Marketto/AvocadoBook/docs/pdf/modello_foglio_schermo_A4.pdf

linguetta: resta fuori dalla fessura per sfilare il foglio

### disegna qui (area visibile dello schermo, 230 x 144 mm)

Taglia lungo la linea continua (235 x 162 mm). Stampa al 100%, senza "adatta alla pagina". Inserisci dal bordo superiore del coperchio.

controllo scala: 50 mm
