Marketto/AvocadoBook/docs/img/avocado.png

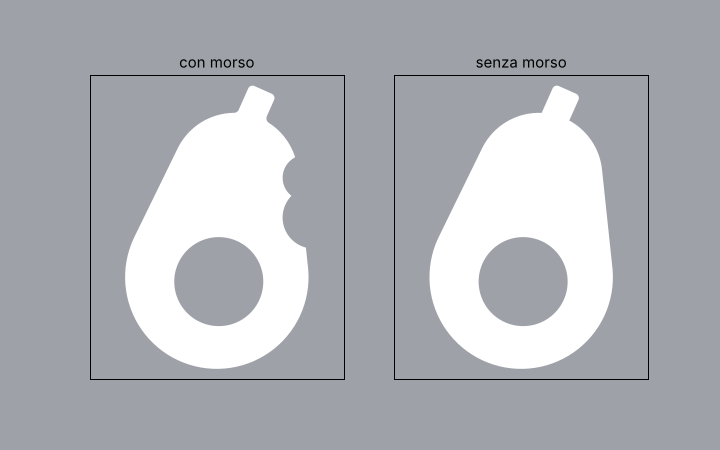
docs/img/avocado.png
