Marketto/AvocadoBook/docs/img/fondo_molle_inserite.png

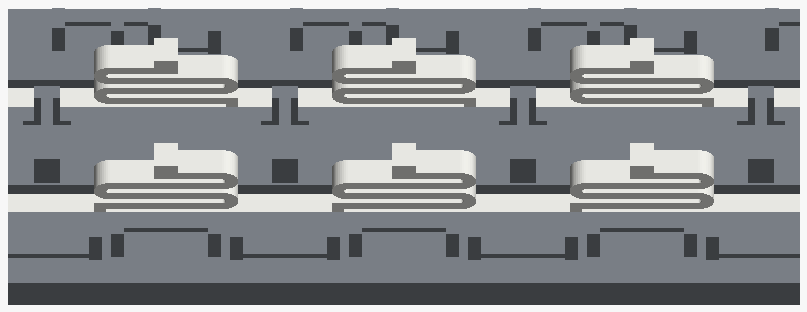
docs/img/fondo_molle_inserite.png
