Marketto/AvocadoBook/docs/img/fondo_scritta.png

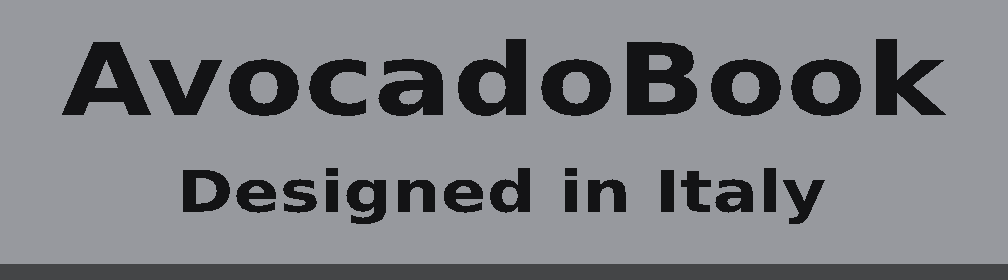
docs/img/fondo_scritta.png
