Marketto/AvocadoBook/docs/img/sezione_cerniera.png

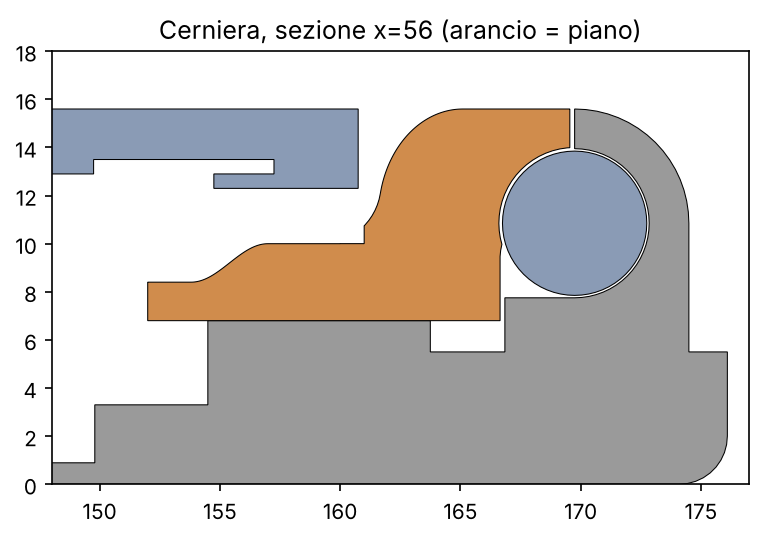
docs/img/sezione_cerniera.png
