Marketto/AvocadoBook/print/AvocadoBook_progetto.3mf

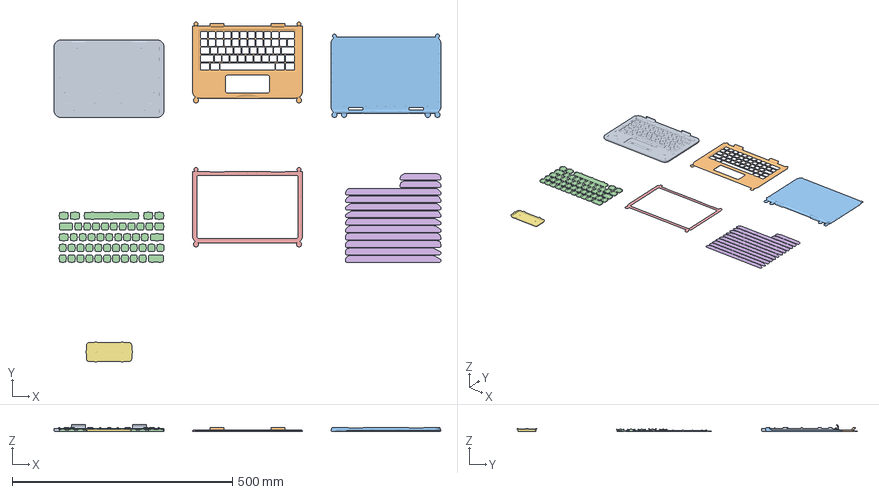
[picture p6: CAD file, 2026-11-07]
print/AvocadoBook_progetto.3mf
878.8 x 772.4 x 15.6 mm
1_fondo - 1 GRIGIO PETG + 3 NERO PETG
2_piano - 1 GRIGIO PETG
3_coperchio - 1 GRIGIO PETG + 2 BIANCO PETG + 3 NERO PETG + 4 PLA (supporti)
4_tasti - 2 BIANCO PETG + 3 NERO PETG
5_cornice_schermo - 3 NERO PETG
6_molle_S - 2 BIANCO PETG + 4 PLA (supporti)
7_trackpad - 1 GRIGIO PETG
