Marketto/AvocadoBook/print/plates/6_molle_S_oggetto_unico.3mf

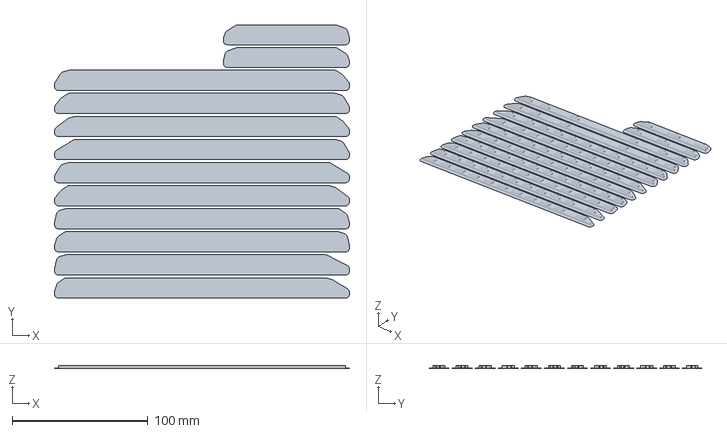
[picture p7: CAD file, 2026-11-07]
print/plates/6_molle_S_oggetto_unico.3mf
217.4 x 201.4 x 2.40 mm
