Marketto/AvocadoBook/print/stl/F_molle_S_fila1_dietro.stl

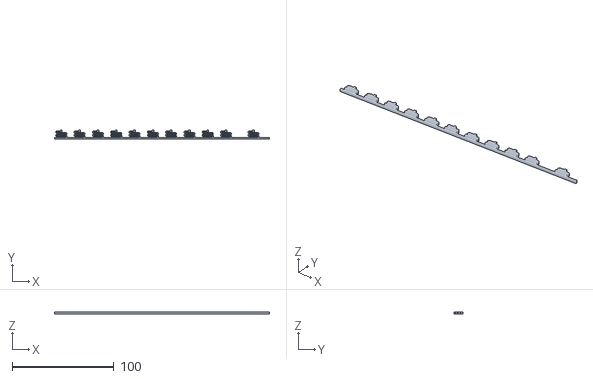
[picture p8: CAD file, 2026-11-07]
print/stl/F_molle_S_fila1_dietro.stl
211.4 x 9.00 x 2.00
