Marketto/AvocadoBook/print/tests/TEST_20_porta_usbc.3mf

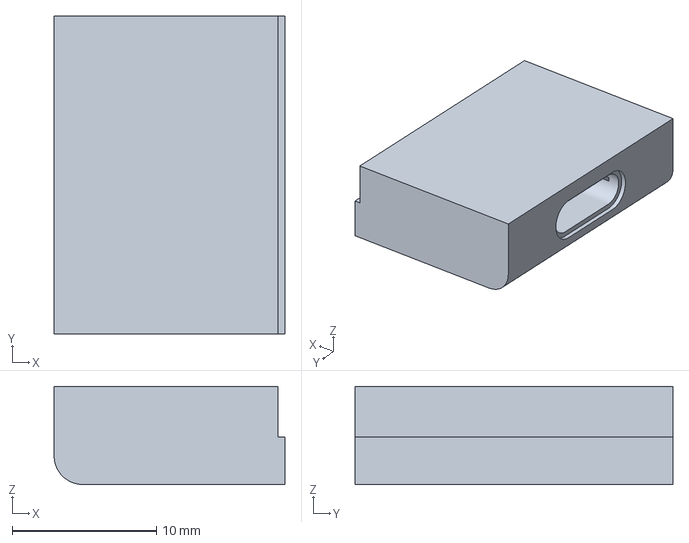
[picture p9: CAD file, 2026-11-07]
print/tests/TEST_20_porta_usbc.3mf
16.0 x 22.0 x 6.80 mm
