Marketto/AvocadoBook/print/plates/5_cornice_schermo.3mf

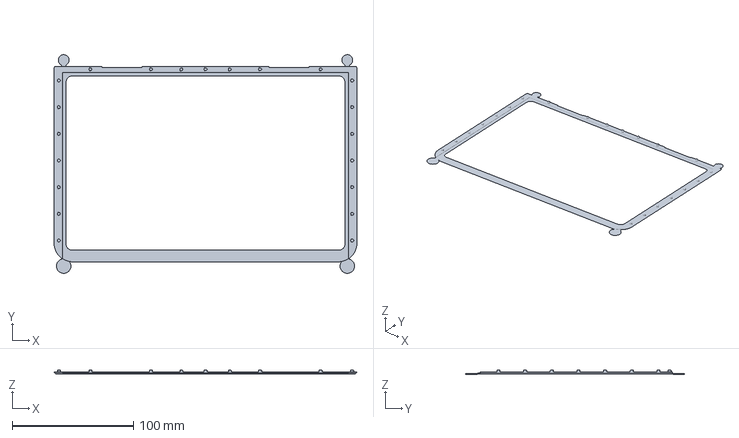
[picture p10: CAD file, 2026-11-07]
print/plates/5_cornice_schermo.3mf
250.0 x 180.5 x 3.70 mm
