Marketto/AvocadoBook/print/stl/D_tasti.stl

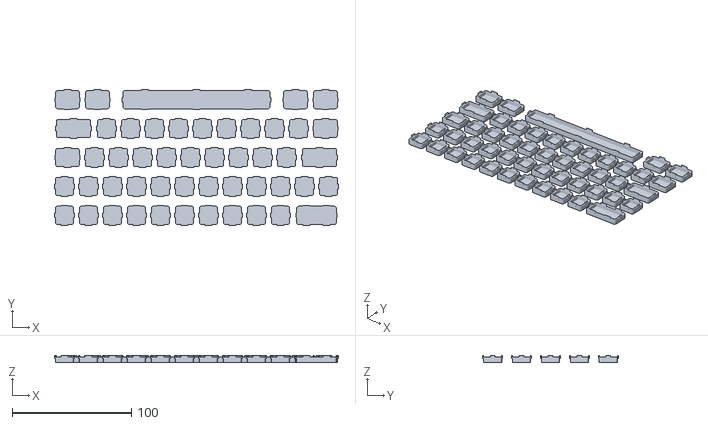
[picture p11: CAD file, 2026-11-07]
print/stl/D_tasti.stl
238.6 x 114.0 x 6.00
