Marketto/AvocadoBook/print/tests/TEST_27_cerniera_senza_fessure.3mf

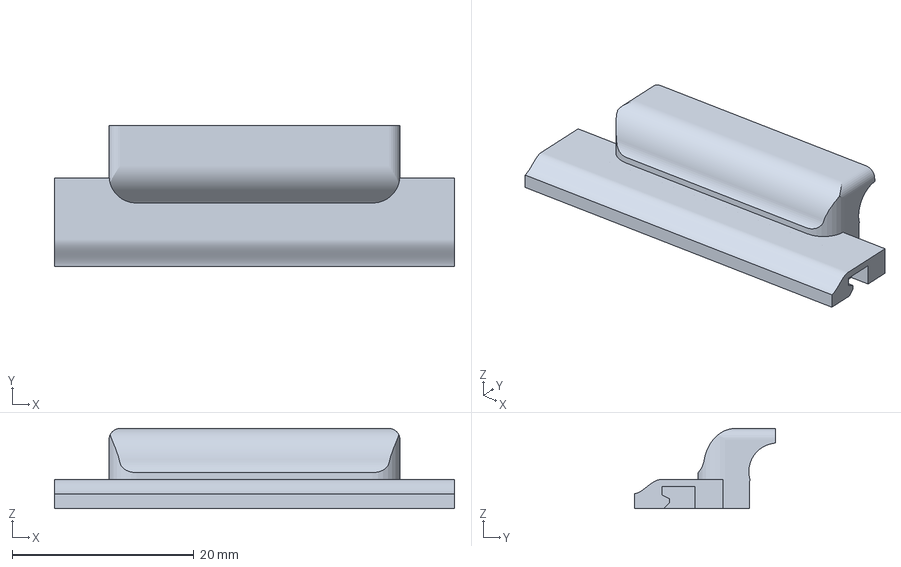
[picture p12: CAD file, 2026-11-07]
print/tests/TEST_27_cerniera_senza_fessure.3mf
44.0 x 15.6 x 8.80 mm
