Marketto/AvocadoBook/print/plates/1_fondo.3mf

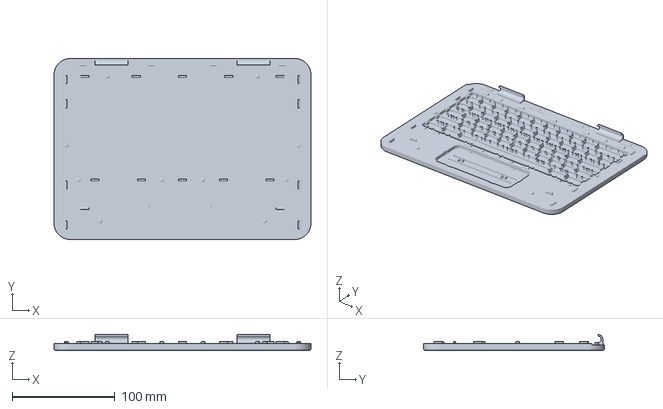
[picture p13: CAD file, 2026-11-07]
print/plates/1_fondo.3mf
250.0 x 176.1 x 15.6 mm
1 GRIGIO PETG
3 NERO PETG
