Marketto/AvocadoBook/print/stl/C_supporto_PLA.stl

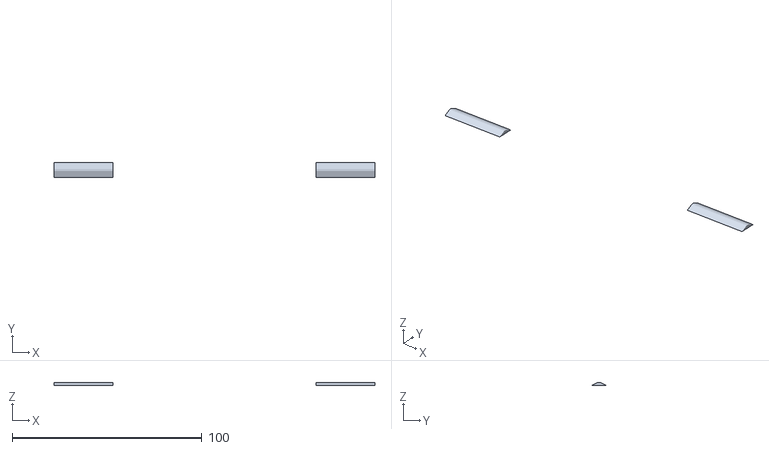
[picture p14: CAD file, 2026-11-07]
print/stl/C_supporto_PLA.stl
169.2 x 8.00 x 1.65
