Marketto/AvocadoBook/print/tests/TEST_28_fondo_avocadobook.3mf

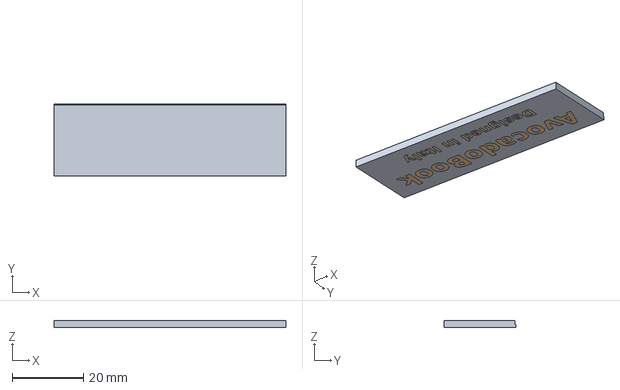
[picture p15: CAD file, 2026-11-07]
print/tests/TEST_28_fondo_avocadobook.3mf
65.1 x 20.1 x 2.00 mm
1 GRIGIO PETG
3 NERO PETG
