Marketto/AvocadoBook/print/plates/2_piano.3mf

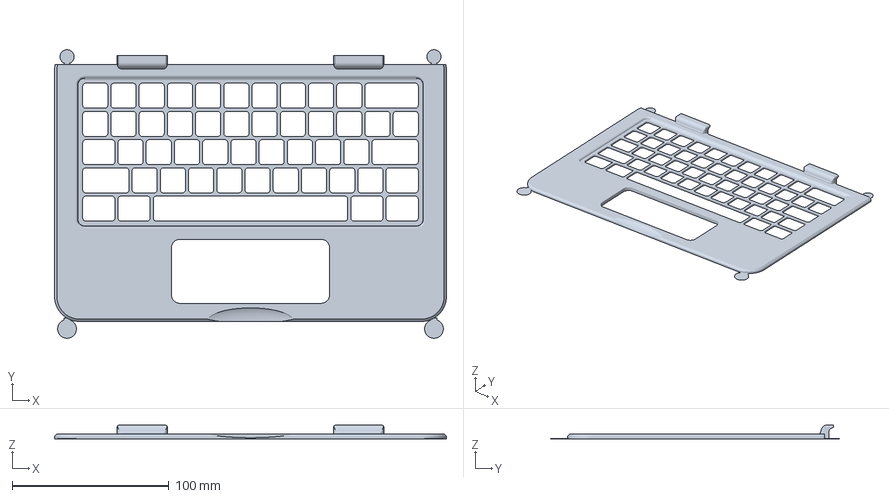
[picture p16: CAD file, 2026-11-07]
print/plates/2_piano.3mf
250.0 x 184.1 x 8.80 mm
