Marketto/AvocadoBook/print/stl/F_molle_S_trackpad_dietro.stl

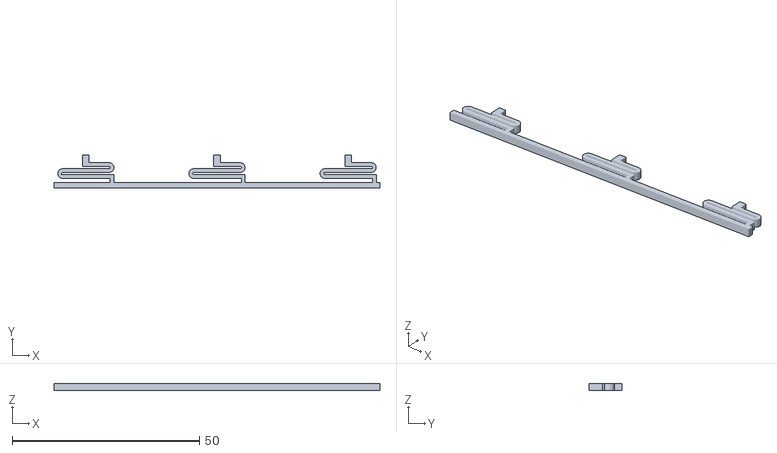
[picture p17: CAD file, 2026-11-07]
print/stl/F_molle_S_trackpad_dietro.stl
87.0 x 8.70 x 2.00
