Marketto/AvocadoBook/print/plates/3_coperchio_oggetto_unico.3mf

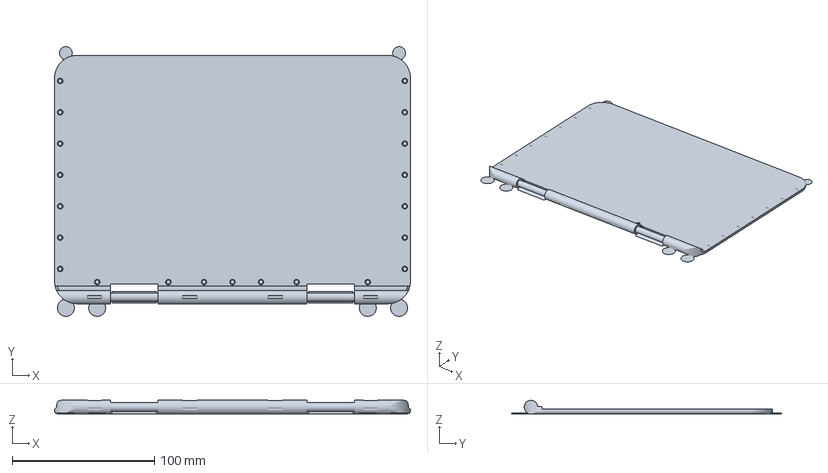
[picture p18: CAD file, 2026-11-07]
print/plates/3_coperchio_oggetto_unico.3mf
250.0 x 189.4 x 9.50 mm
