Marketto/AvocadoBook/print/plates/7_trackpad.3mf

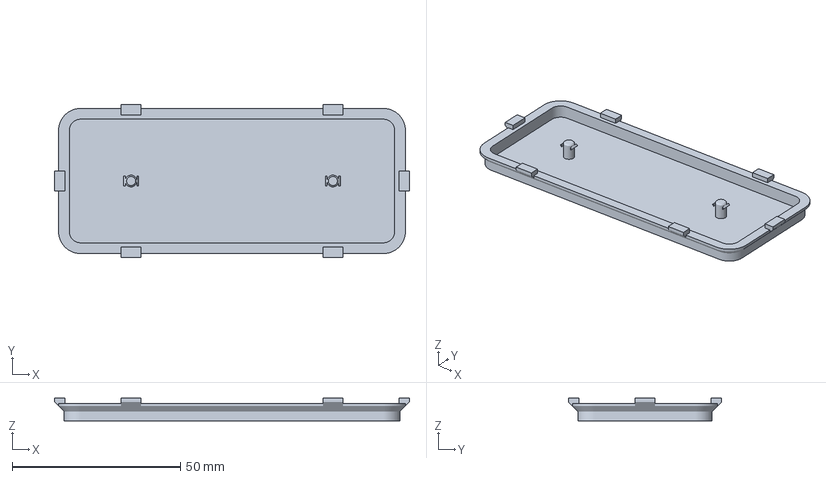
[picture p19: CAD file, 2026-11-07]
print/plates/7_trackpad.3mf
105.6 x 45.6 x 6.70 mm
