Marketto/AvocadoBook/print/stl/C_coperchio_schermo.stl

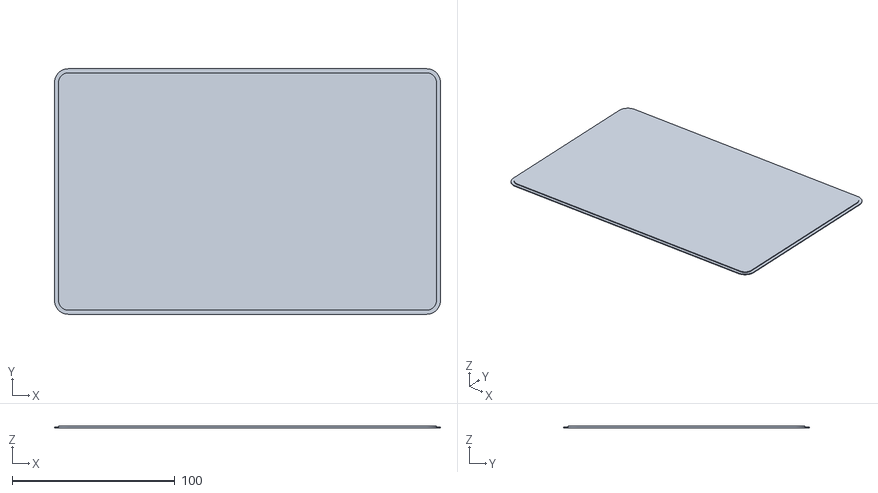
[picture p20: CAD file, 2026-11-07]
print/stl/C_coperchio_schermo.stl
237.0 x 150.7 x 1.20
