Marketto/AvocadoBook/print/plates/4_tasti.3mf

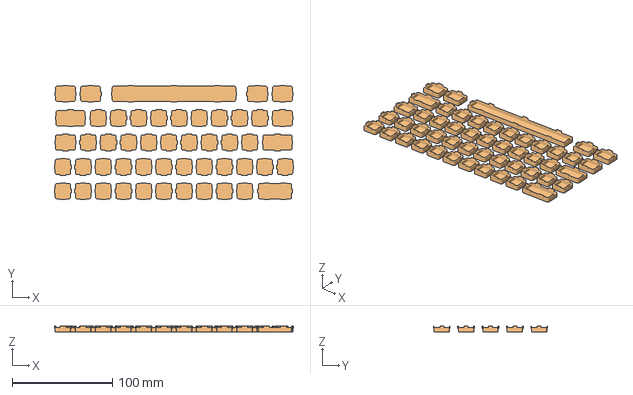
[picture p21: CAD file, 2026-11-07]
print/plates/4_tasti.3mf
238.6 x 114.0 x 6.00 mm
2 BIANCO PETG
3 NERO PETG
