Marketto/AvocadoBook/print/stl/D_lettere.stl

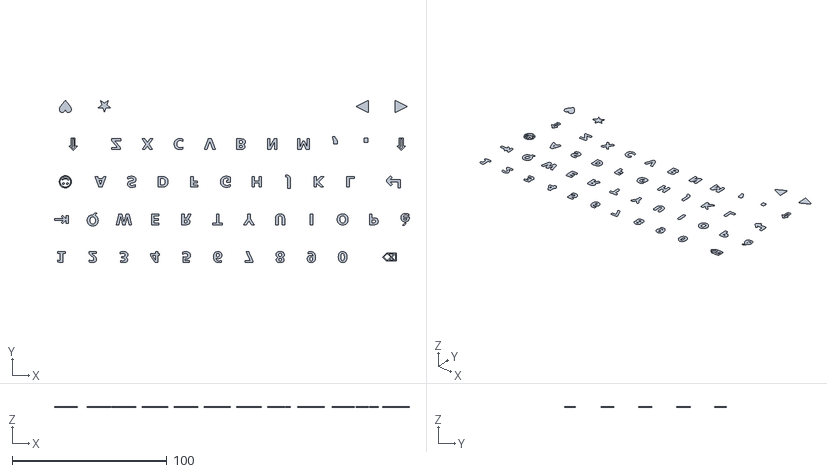
[picture p22: CAD file, 2026-11-07]
print/stl/D_lettere.stl
229.1 x 104.8 x 0.6
