Marketto/AvocadoBook/print/stl/A_fondo_scritta_nera.stl

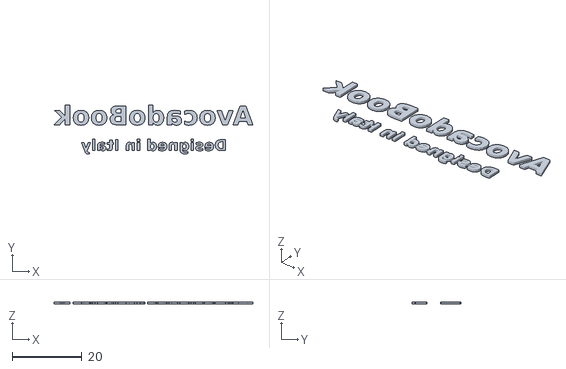
[picture p23: CAD file, 2026-11-07]
print/stl/A_fondo_scritta_nera.stl
57.1 x 14.1 x 0.6
