Marketto/AvocadoBook/print/stl/F_fogli_PLA.stl

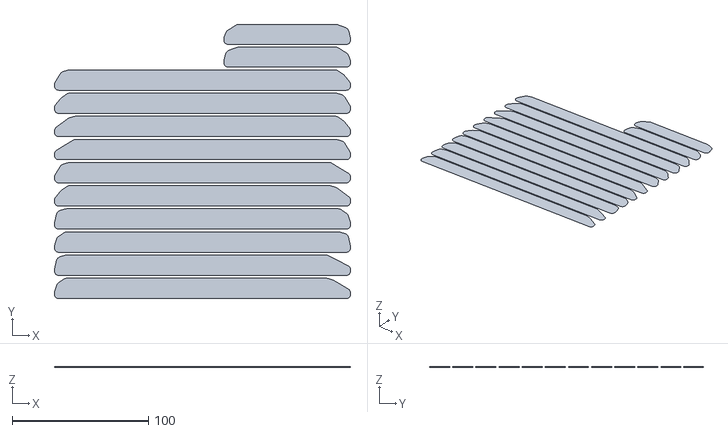
[picture p24: CAD file, 2026-11-07]
print/stl/F_fogli_PLA.stl
217.4 x 201.4 x 0.4
