Marketto/AvocadoBook/print/stl/C_coperchio_corpo.stl

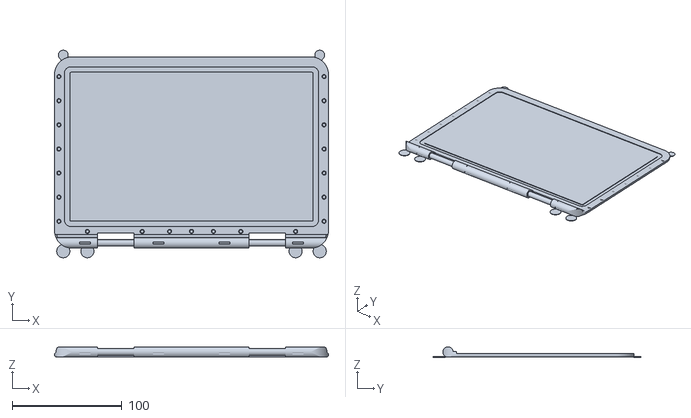
[picture p25: CAD file, 2026-11-07]
print/stl/C_coperchio_corpo.stl
250.0 x 189.4 x 9.50
