Marketto/AvocadoBook/print/stl/C_coperchio_logo.stl

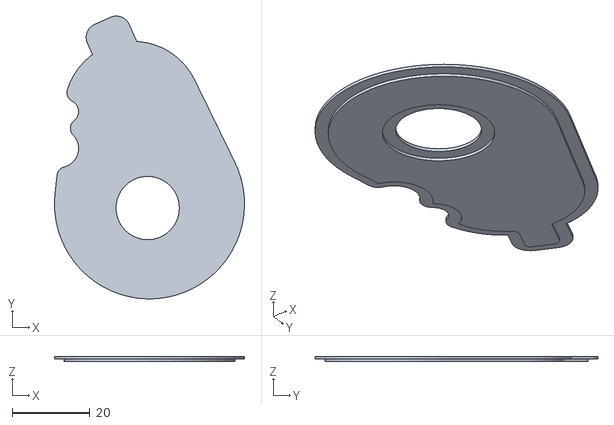
[picture p27: CAD file, 2026-11-07]
print/stl/C_coperchio_logo.stl
48.7 x 72.6 x 1.20
