Marketto/AvocadoBook/(list of files, cad)

Other CAD files:
print/plates/6_molle_S.3mf
print/stl/F_molle_S_fila1_davanti.stl
print/stl/F_molle_S_fila3_davanti.stl
print/stl/B_piano.stl
print/plates/3_coperchio.3mf
print/stl/F_molle_S_fila4_dietro.stl
print/stl/F_molle_S_fila2_davanti.stl
print/stl/F_molle_S_trackpad_davanti.stl
print/stl/E_cornice.stl
print/stl/A_fondo.stl
print/stl/B_trackpad.stl
print/stl/F_molle_S_fila5_davanti.stl
print/stl/F_molle_S_fila3_dietro.stl
print/stl/F_molle_S_fila4_davanti.stl
