Marketto/AvocadoBook/docs/pdf/istruzioni_montaggio_IT.pdf

# 🥑 AvocadoBook – Istruzioni di montaggio 🔧

⏱️ Circa 30 minuti · 🧑‍🔧 Montaggio a cura di un adulto · 🚫🔩 Niente viti, niente colla, niente attrezzi


### 📦 Cosa ti serve

Piatto | Pezzi
1️⃣ fondo | ⬜ fondo (porta USB‑C, sedi della cerniera, ⬛ scritta nera sotto)
2️⃣ piano | ⬜ piano (con i 2 copri-asse)
3️⃣ coperchio | ⬜ coperchio con ⬛ schermo e 🤍 logo + 🟥 supportino PLA
4️⃣ tasti | ⬛ 50 tasti con 🤍 lettere
5️⃣ cornice | ⬛ cornice dello schermo
6️⃣ molle | 🤍 10 strisce di molle tastiera + 2 trackpad, su 🟥 fogli PLA
7️⃣ trackpad | ⬜ trackpad

️ Come stamparli: vedi la scheda di stampa.

### ✂️ 0. Preparazione dei pezzi

1. 🍃 Stacca le orecchie anti-distacco agli angoli di piano, coperchio e cornice piegandole avanti e indietro con le dita; rifinisci il residuo con una limetta.
2. 🟥 Stacca le molle dai fogli di PLA con le dita (PETG e PLA non si incollano). Togli anche il supportino PLA sotto la cerniera del coperchio.
3. ⚠️ Stacca il piano a piatto freddo piegando la lamiera e non tirarlo mai dai due copri-asse.

### ️ 1. Schermo e cornice

1. Appoggia il coperchio con lo schermo verso l'alto.
2. Infila i pioli della ⬛ cornice nei fori del coperchio e premi lungo il bordo finché è a filo. 👌

### 🌀 2. Molle nel fondo

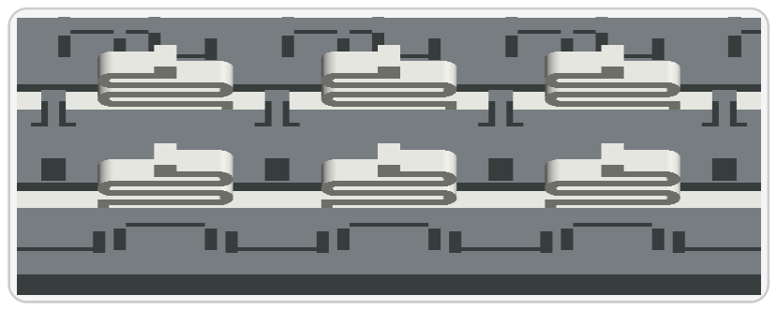
[picture p31: figure]

1. Ogni striscia ha il nome nel file: fila 1 = numeri … fila 5 = barra spaziatrice, davanti / dietro.
2. Infila ogni striscia in piedi nella sua scanalatura, barretta dritta in basso. Le S di quella "dietro" sono specchiate. 🔁
3. Fai lo stesso con le 2 strisce corte del trackpad.
4. ✅ Le molle devono scendere fino in fondo senza forzare.

### ⌨️ 3. Tasti e trackpad

1. Appoggia ogni tasto sulle sue due molle: le 4 alette entrano nei canali delle nervature.
2. Appoggia il ️ trackpad sulle sue molle, con il bordino nella sua sede.

💡 Trucco: lavora una fila alla volta partendo da dietro e controlla che ogni tasto stia dritto.

### 🔗 4. Coperchio sul fondo

1. Fai scorrere l'asse della cerniera orizzontalmente, da davanti, nelle due sedi sul retro del fondo.
2. 📐 Apri il coperchio ad almeno 105°: a 90° lo schermo intralcia il piano.

### 🔒 5. Chiusura con il piano

1. Appoggia il piano dall'alto facendo passare tasti e trackpad nei loro fori; i due copri-asse scendono sopra l'asse e lo bloccano.
2. Premi con il palmo, prima dietro e poi verso il davanti, finché tutti i ganci fanno click. 🔊
3. ⚠️ Non forzare: se qualcosa non scende, solleva e controlla che nessun tasto sia storto.

### ✅ 6. Controllo finale

⌨️ Ogni tasto scende e risale da solo.
️ Il trackpad è a filo e fa click.
🔌 Un cavo USB‑C entra e resta agganciato.
️ Il coperchio si chiude e si ferma aperto a circa 105°.

🔒 I tasti sono pensati per non potersi togliere: il laptop non è fatto per essere smontato

🚸 Sicurezza: contiene piccole parti, non adatto a bambini sotto i 3 anni. Controlla ogni tanto che non ci siano pezzi rotti o spigoli taglienti. 🎉 Buon divertimento!
