Marketto/AvocadoBook/TODO_v2.md

# Idee e problemi aperti per la v2 (v1 consolidata il 2026-11-06)

## Da risolvere (visti sul laptop montato)
- Il coperchio non si chiude del tutto (resta ~3 mm aperto davanti, resistenza negli ultimi gradi). Nel modello
  chiude senza contatti anche con il piano 0,45 mm più alto -> causa di stampa. Ipotesi da verificare con le 3 prove:
  A) solo fondo + coperchio, B) premere il davanti, C) coperchio su un piano. Cause probabili: dentino degli
  scatti che non entra nell'incavo (incavo più profondo/largo), coperchio imbarcato, copri-asse.
- Piano che "balla" vicino alla cerniera sinistra: probabile arco sopra l'asse abbassato in stampa che appoggia
  sull'asse (gioco 0,15). Correzione pronta da fare: foro ovale, gioco 0,45 in alto / 0,15 ai lati.
- Schermo che sta su solo a ~105°: incavi solo a 0 e 105. Aggiungere 90/105/120/135° (ristampa coperchio).

## Miglioramenti
- Finestrella nel bordo dello schermo (incavo della cerniera) da chiudere.
- Copri-asse più robusto: pezzo separato stampato sdraiato (arco nel piano degli strati) o piano a faccia in giù.
- Linea continua tastiera -> copri-asse (terzo disegno dell'utente): oggi c'è un tratto piatto di ~2,5 mm perché
  sotto ci sono le tasche dei ganci posteriori: spostare quei ganci/pioli permetterebbe la linea unica.
- Montaggio più facile dei 50 tasti (smussi d'invito nei canali, molle trattenute nel fondo, montaggio capovolto).
- Piano stampato a faccia in giù per una superficie liscia (oggi impedito dai copri-asse che sporgono).
- Istruzioni di montaggio e scheda di stampa almeno in inglese.
